UBC-GSRC/2026-w2-hassan-load_cell_sediment_trap/README.md

# 2026-W2-Hassan-load_cell_sediment_trap

This repository will hold the firmware to collect data on a field deployable sediment trap equipped with load cells. The idea is to get a weight reading every 15 minutes for the rainy season in Malcom Knapp Research Forest.
