UBC-GSRC/2026-w2-hassan-load_cell_sediment_trap/load_cell_sediment_trap.pdf

# Load Cell Sediment Trap

September 28, 2026

## Components

. Outer aluminum box
2. Inner aluminum box
3. Box lid with cutout
4. Bolt and wingnuts to fix the lid to the outer box
5. Wooden box in the creek bed
6. Three waterproof load cells
7. Data logger

## Important Design Considerations

. The lid and inner box must be easily removed while submerged in water. This means no power tools necessary and ideally no tools at all.
2. The inner box has to be fixed to the load cells so that it does not lean on the outer box at all when sediment is added. All weight additions must be felt by the cells and only the cells. As far as I can tell, it is not possible to use less than three load cells without making a different box design.
3. Make room for wires in the outer wooden box.

# Images with Annotations

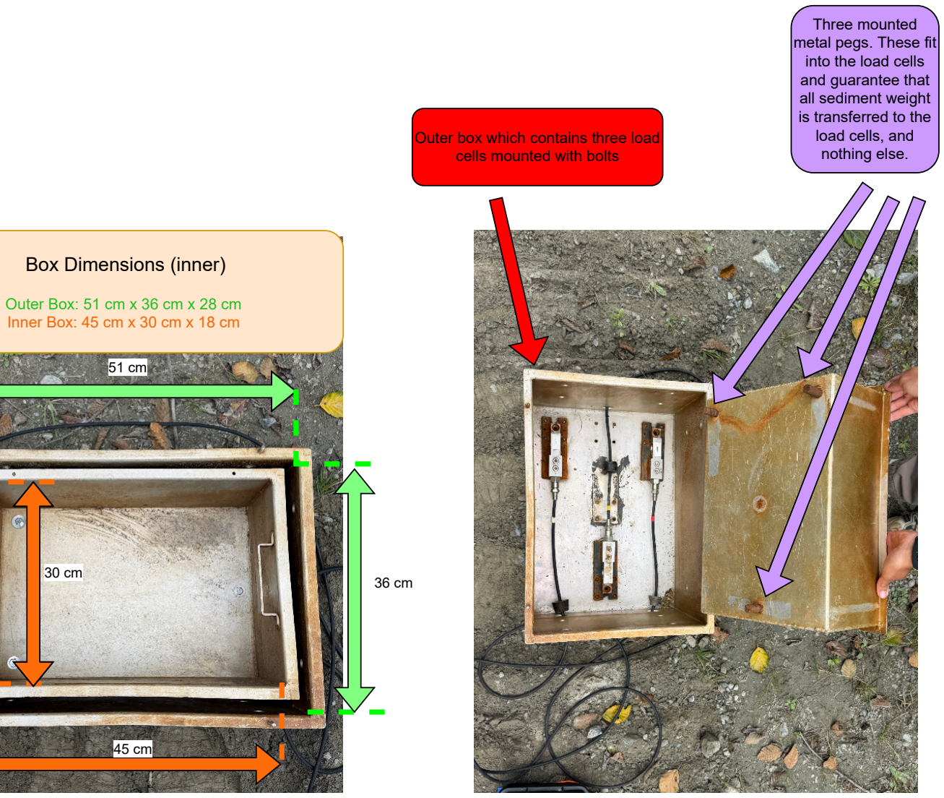
[picture p1: figure]
Outer box which contains three load cells mounted with bolts; Three mounted metal pegs. These fit into the load cells and guarantee that all sediment weight is transferred to the load cells, and nothing else.; Box Dimensions (inner); Outer Box: 51 cm x 36 cm x 28 cm Inner Box: 45 cm x 30 cm x 18 cm
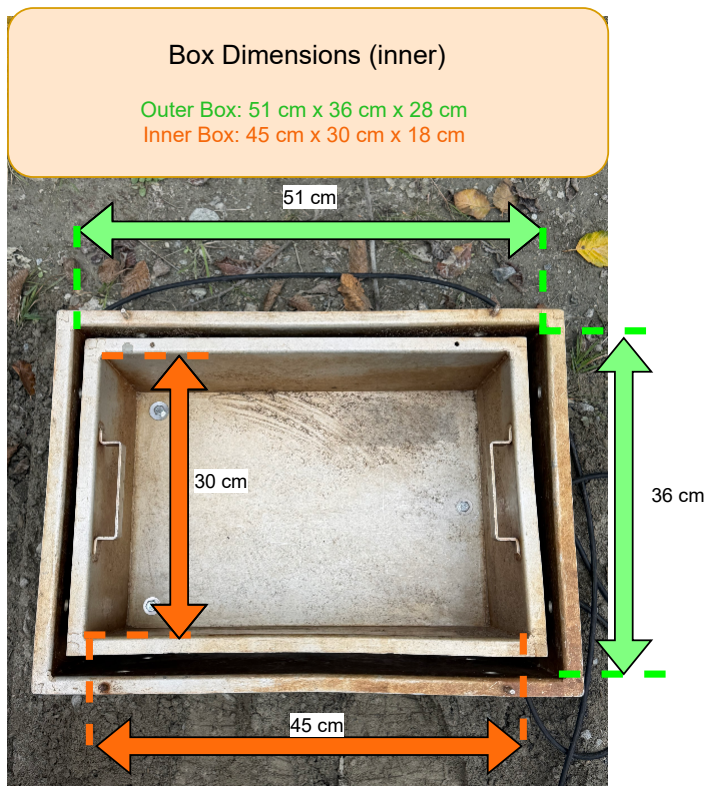
[picture p2: figure]
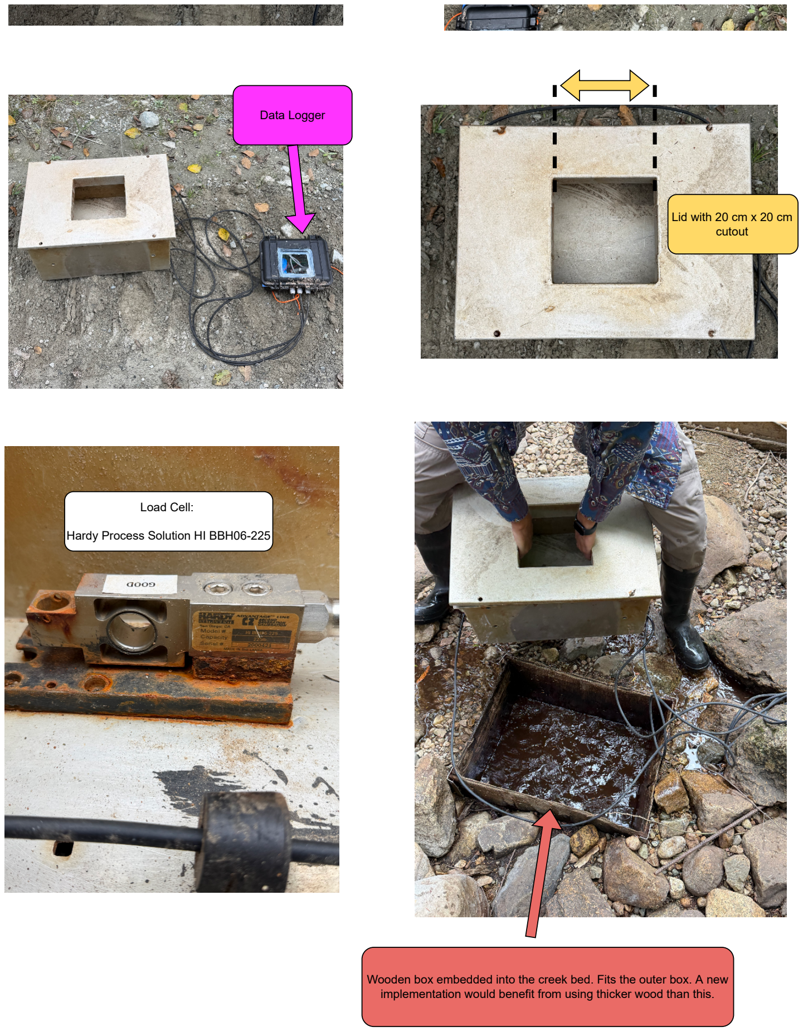
[picture p3: page 2]

Data Logger

Lid with 20 cm x 20 cm
cutout

Load Cell:

Hardy Process Solution HI BBH06-225

Wooden box embedded into the creek bed. Fits the outer box. A new implementation would benefit from using thicker wood than this.
