UBC-GSRC/2026-w2-hassan-load_cell_sediment_trap/kicad/data_logger_load_cell/data_logger_load_cell.kicad_pcb

## KiCad design KiCad_PCB/Screen_Bot/Screen_Bot.kicad_sch

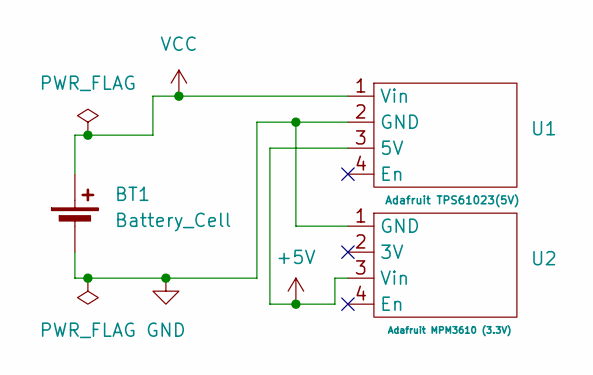
[picture p4: schematic Screen_Bot.kicad_sch]

Parts:
BT1: Battery_Cell; Banana_Jack_2Pin
U1: Adafruit TPS61023(5V); Adafruit_TPS61023
U2: Adafruit MPM3610 (3.3V); Adafruit_MPM3610

Connections:
+5V: U1.3 (5V), U2.3 (Vin)
GND: BT1.2 (-), U1.2 (GND), U2.1 (GND)
VCC: BT1.1 (+), U1.1 (Vin)
