UBC-GSRC/2026-w2-hassan-load_cell_sediment_trap/main_nano.cpp

#include "HX711.h"

// HX711 circuit wiring
const int LOADCELL_DOUT_PIN = 2;
const int LOADCELL_SCK_PIN = 13;

HX711 scale;

void setup() {
  Serial.begin(57600);
  scale.begin(LOADCELL_DOUT_PIN, LOADCELL_SCK_PIN);
  scale.tare();
  scale.set_scale(-3233933.0 / 175.0);
}

void loop() {     

  if (scale.wait_ready_timeout(1000)) {
    long reading = scale.get_units();
    Serial.print("HX711 reading: ");
    Serial.println(reading);
  } else {
    Serial.println("HX711 not found.");
  }

  delay(333);
  
}
