UBC-GSRC/2026-w2-hassan-load_cell_sediment_trap/(commit log)

2026-01-14 Got the basic reading of three load cells down and soldered onto a solderable breadboard.
    [data_logger_load_cell.kicad_pcb, data_logger_load_cell.kicad_sch]
2026-01-14 Updates to schematics
    [data_logger_load_cell.kicad_sch]
2026-01-14 Updating the schematics to correctly show the connections
    [data_logger_load_cell.kicad_sch]
2026-09-28 Adding rough schematics of the box situation in the creek
2026-09-28 Sediment trap rough schematics updates
